gom9000/xp-presepe/backplane-board/README.md

# *Backplane* Board
BUS backplane with 7 slots for line boards.

board-built

## Schematic
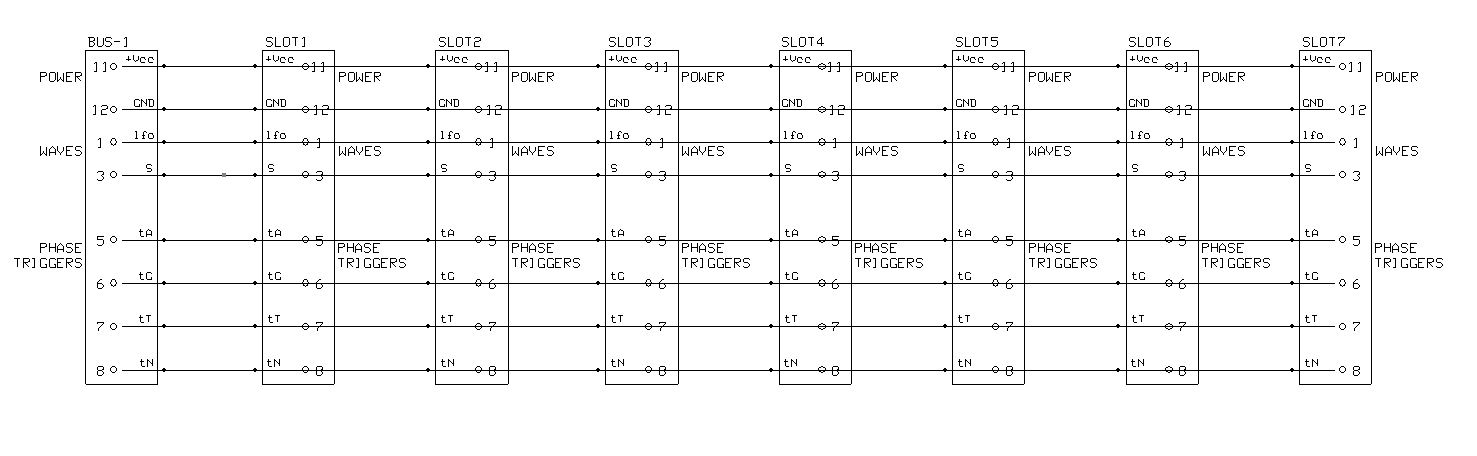
[picture p14: backplane-board/presepe-backplane-board_sch.jpg]
board-schematic


## PCB Layout
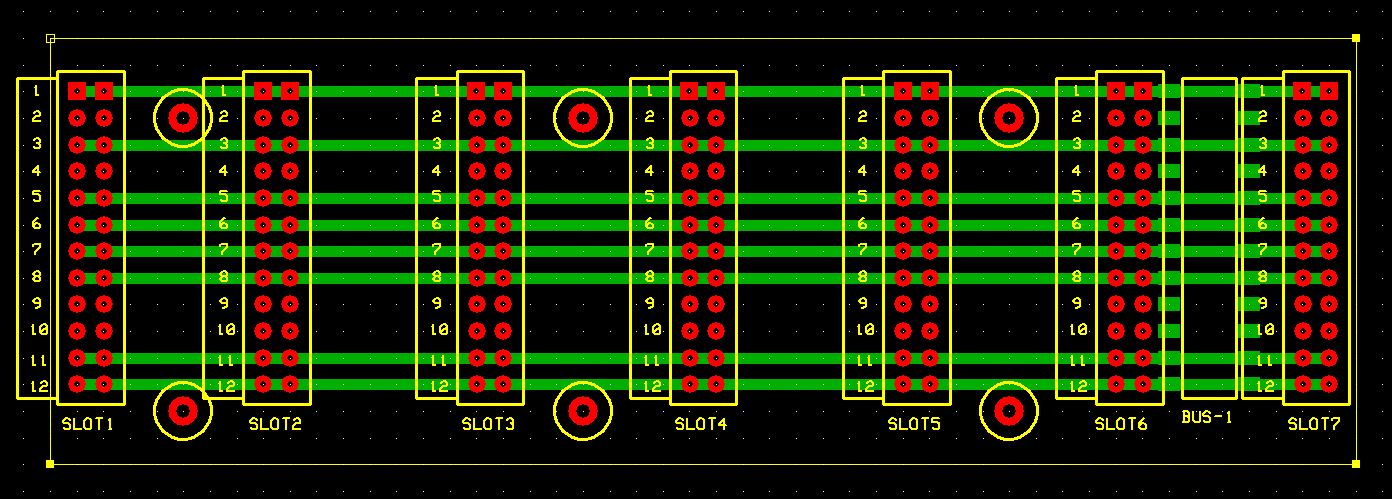
[picture p15: backplane-board/presepe-backplane-board_pcb.jpg]
board-pcb


## Bill of Materials
- [x] paperboard 15x9cm cropped to 47x15M (1M=.1inches)
- [x] 7 x DIL 12-pin female header
- [x] DIL 12-pin female header smd
