gom9000/xp-presepe/resources/ltspice-lfo.jpg

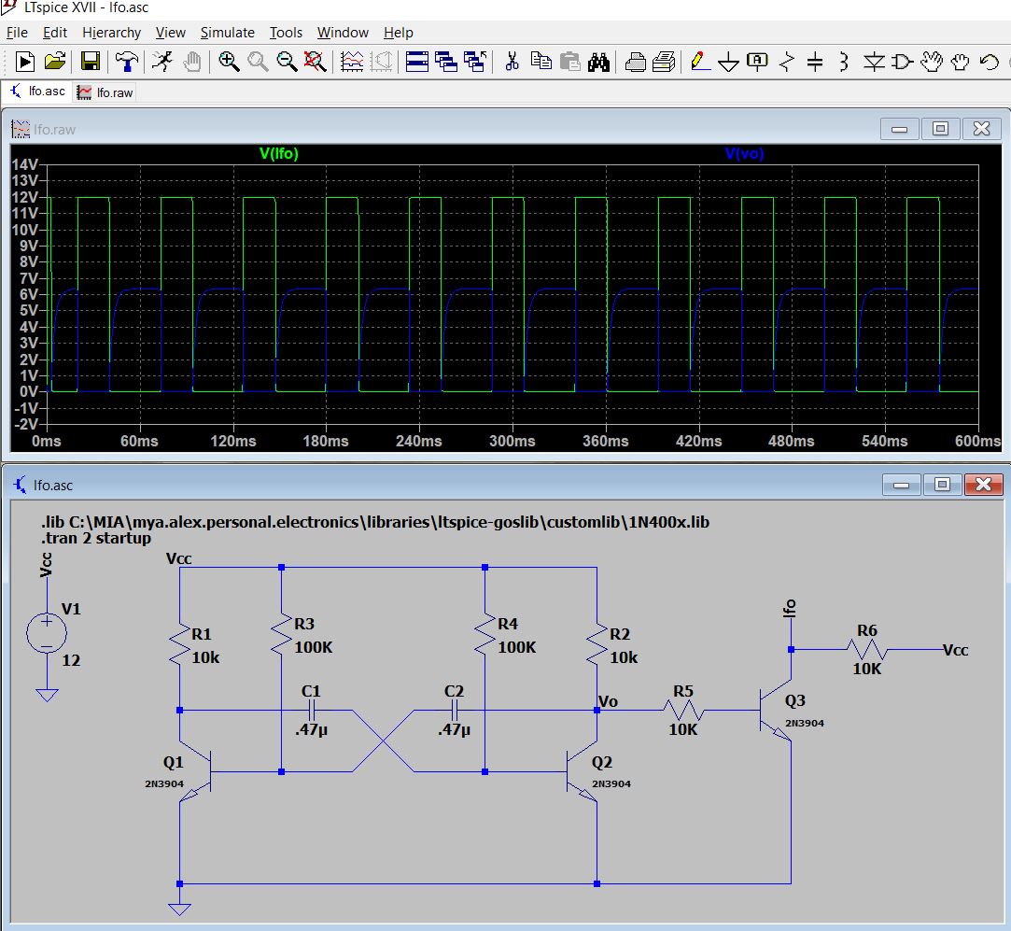
resources/ltspice-lfo.jpg
