gom9000/xp-presepe/resources/ltspice-phase-triggers-mixer.jpg

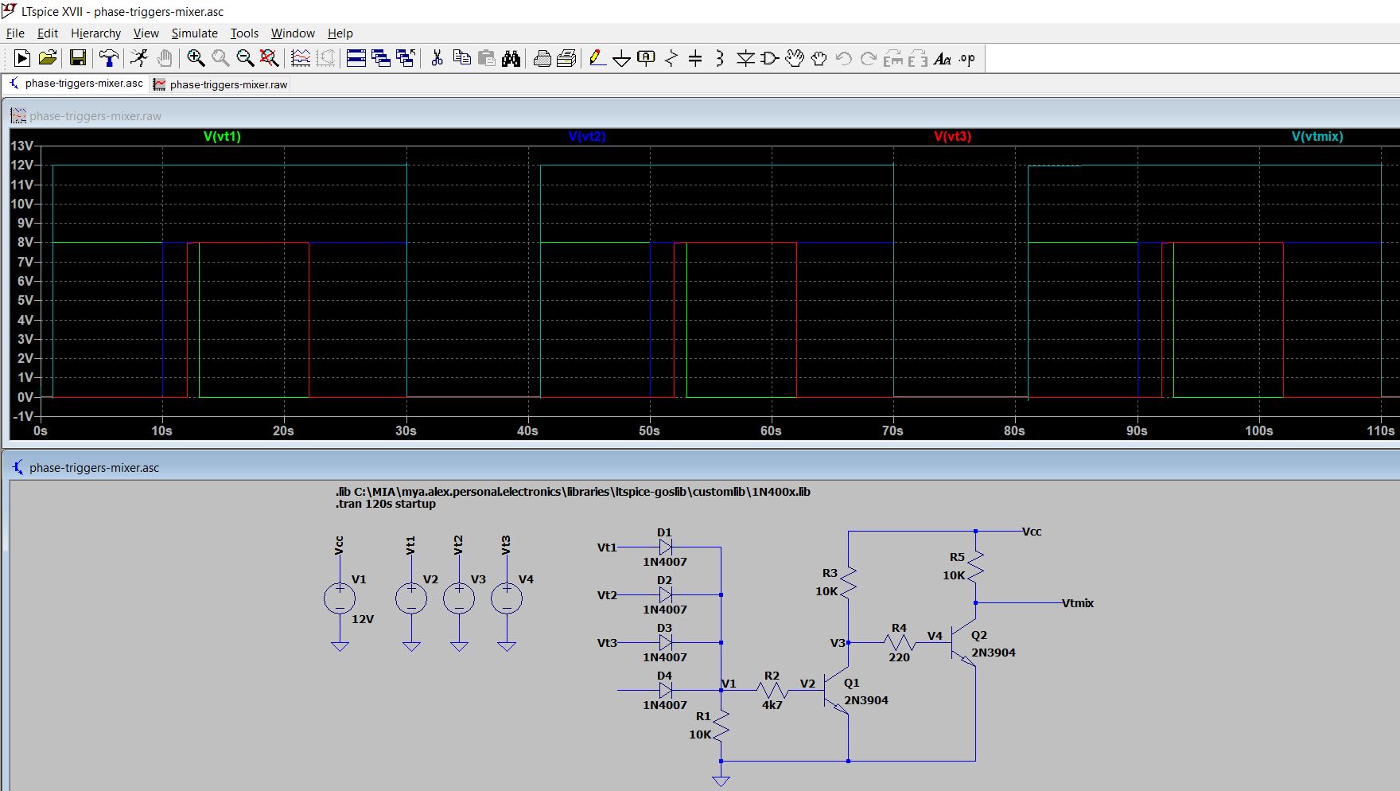
resources/ltspice-phase-triggers-mixer.jpg
