gom9000/xp-presepe/resources/ltspice-phase-triggers-voltage-reference.jpg

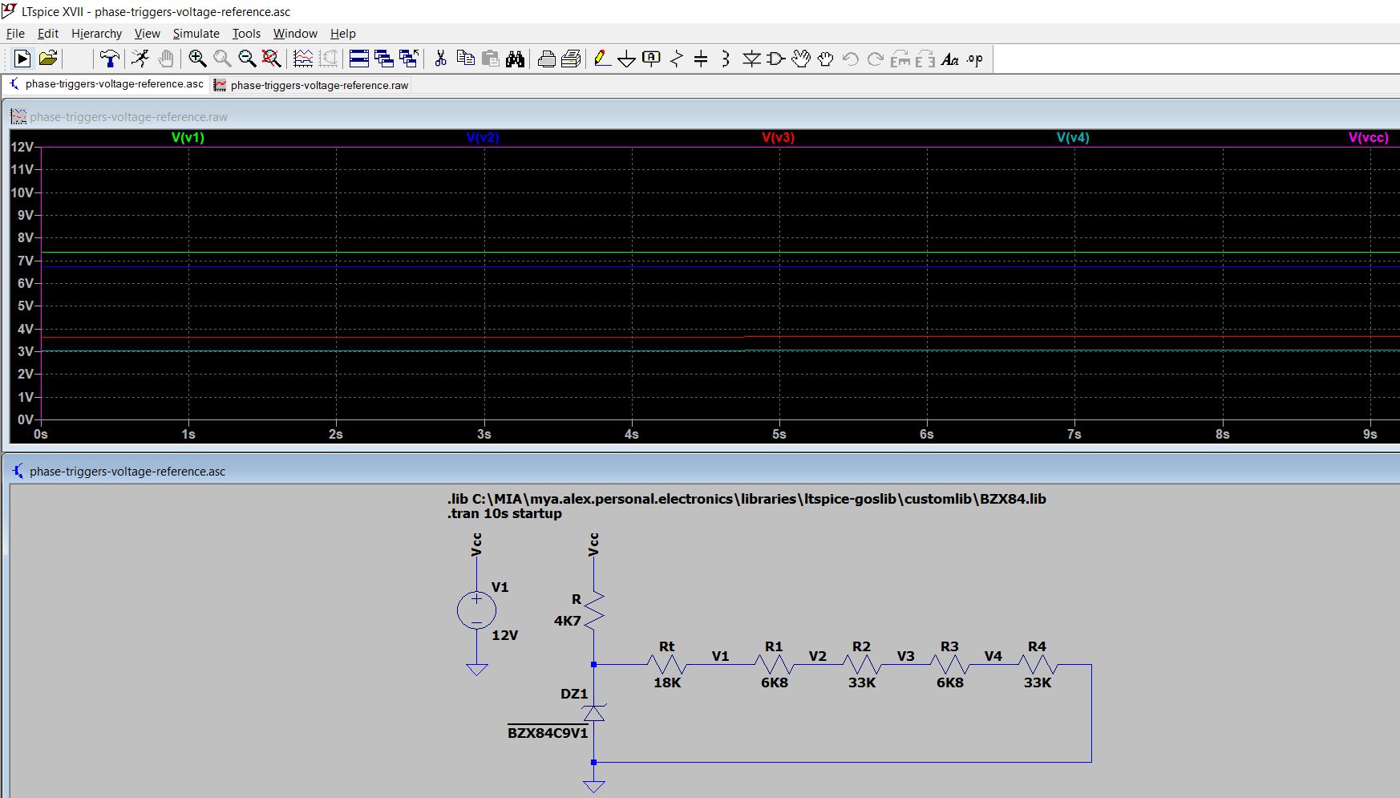
resources/ltspice-phase-triggers-voltage-reference.jpg
