gom9000/xp-presepe/resources/ltspice-sawtooth.jpg

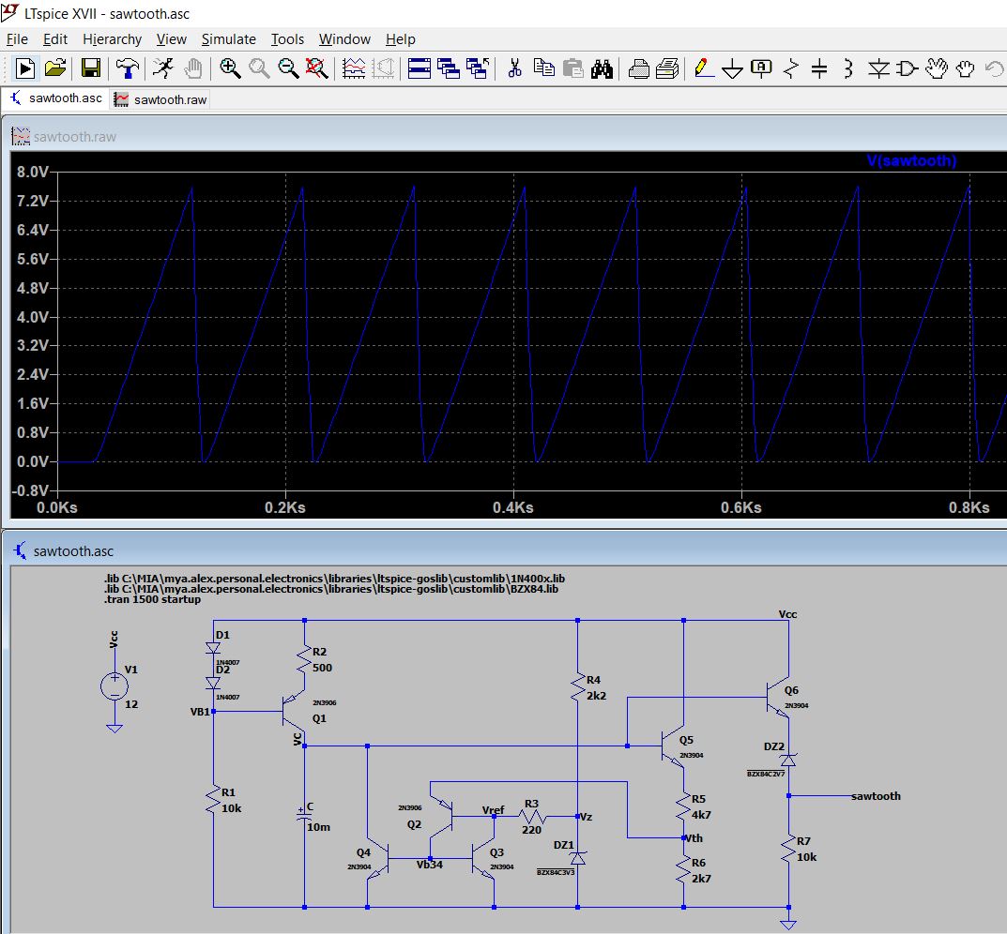
resources/ltspice-sawtooth.jpg
