gom9000/xp-presepe/resources/ltspice-transitions-generator.jpg

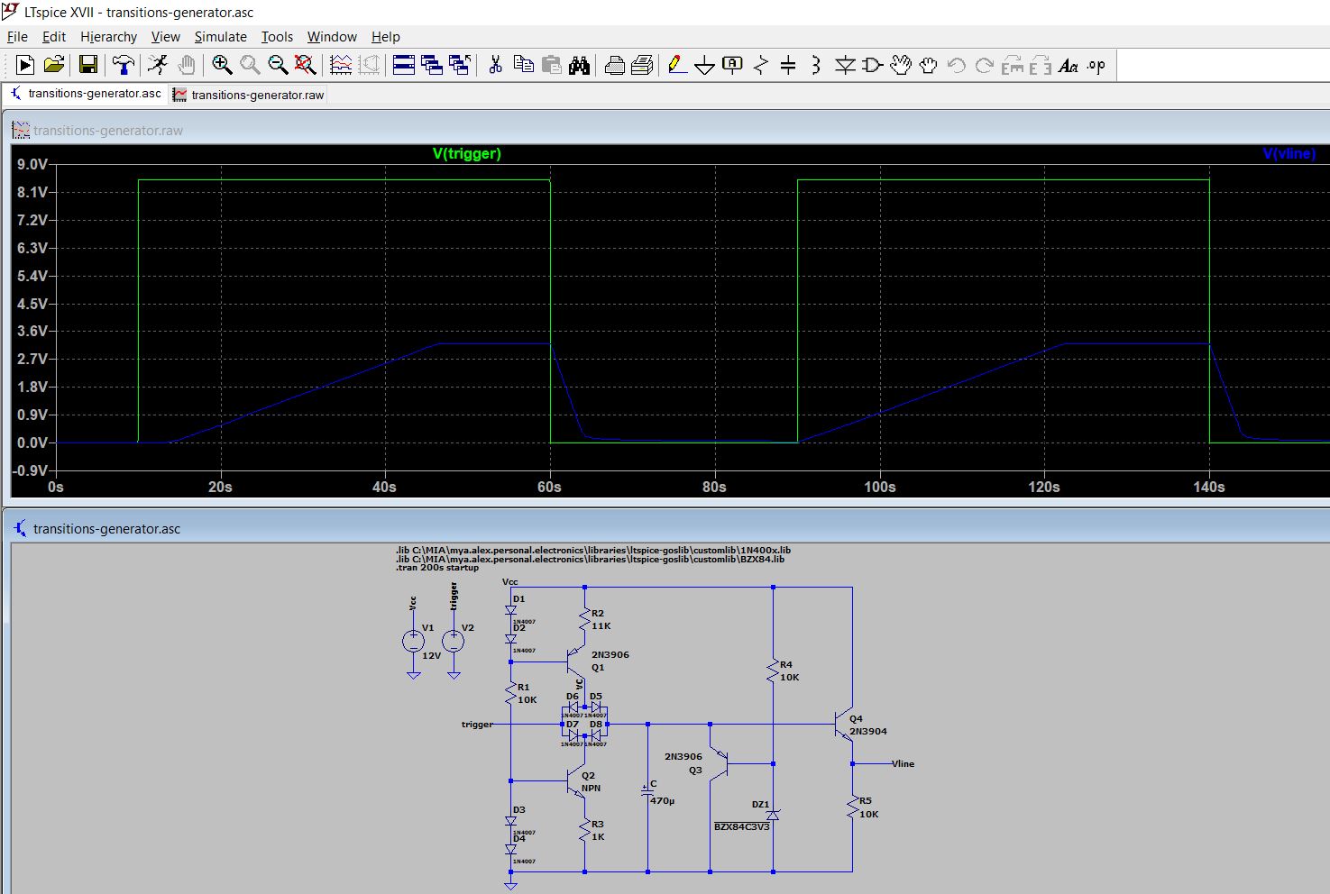
resources/ltspice-transitions-generator.jpg
