gom9000/xp-presepe/resources/ltspice-vline-lfo-mixer.jpg

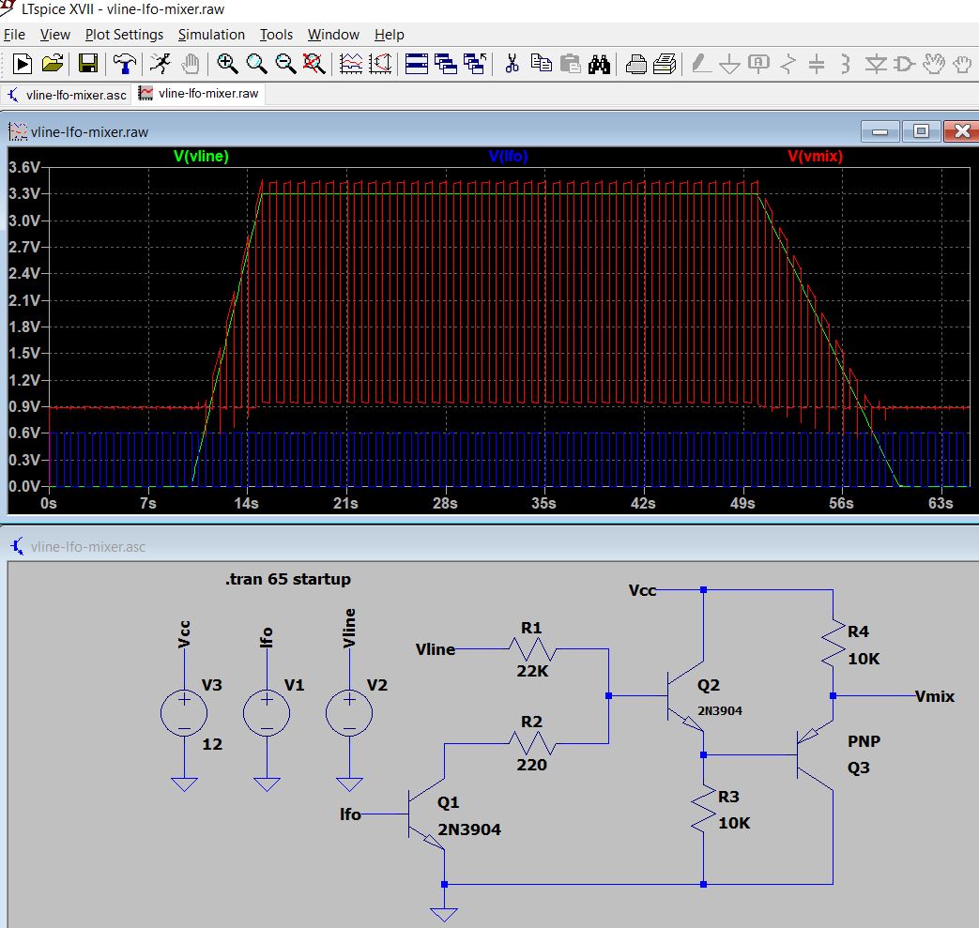
resources/ltspice-vline-lfo-mixer.jpg
