gom9000/xp-presepe/resources/ltspice-voltage-to-current-and-mirror.jpg

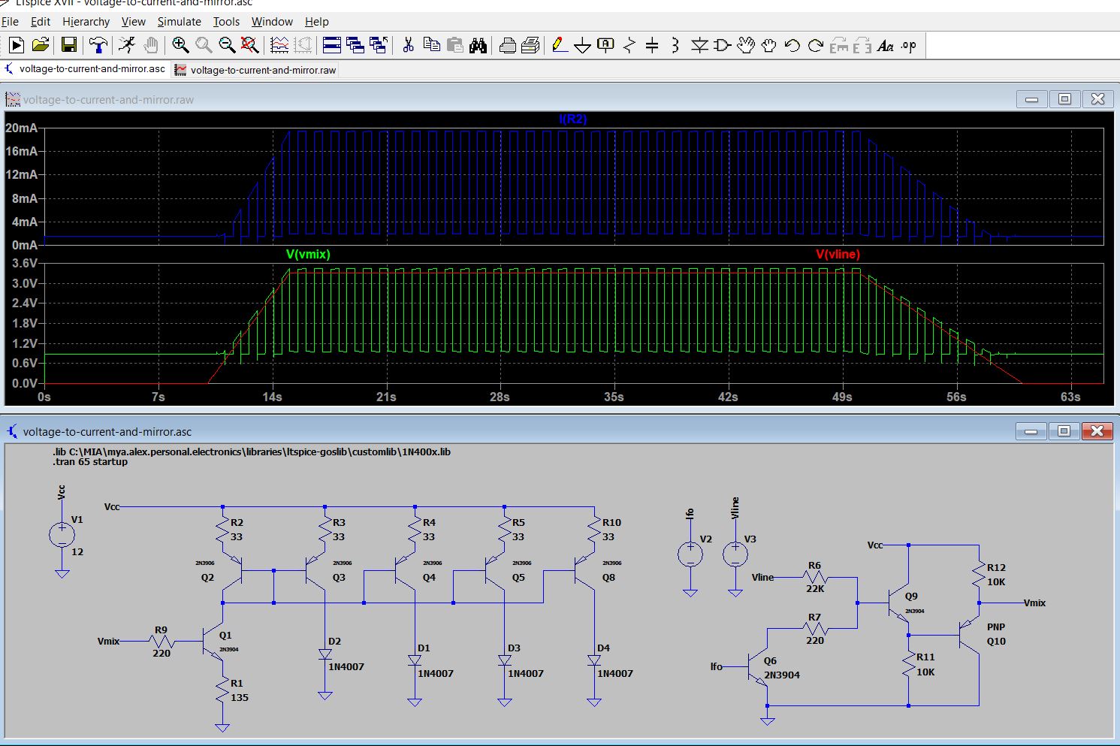
resources/ltspice-voltage-to-current-and-mirror.jpg
