gom9000/xp-presepe/resources/presepe-lfo.jpg

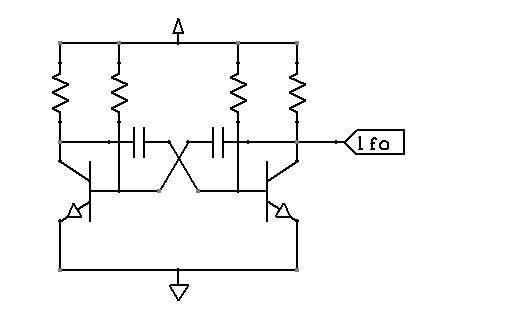
resources/presepe-lfo.jpg
