gom9000/xp-presepe/(list of files, drawings)

Other design files:
backplane-board/presepe-backplane-board.pcb
phases-lines-board/presepe-phases-lines-board.pcb
triggers-board/presepe-triggers-board.pcb
waves-board/presepe-waves-board.pcb
