gom9000/xp-presepe/(commit log)

2021-03-22 add phases lines board
    [presepe-phases-lines-board.pcb, presepe-phases-lines-board.sch]
2021-03-22 fix phases line board pcb
    [presepe-phases-lines-board.pcb]
2021-03-22 add logical modules images
    [presepe-modules.sch]
2021-03-23 fix phases-lines-board
    [presepe-phases-lines-board.pcb, presepe-phases-lines-board.sch]
2021-03-26 add backplane board
    [presepe-backplane-board.pcb, presepe-backplane-board.sch]
2021-03-27 add phases line board built
    [presepe-phases-lines-board.pcb]
2021-03-28 update backplane board
    [presepe-backplane-board.pcb]
2021-03-29 add main board schematics
    [presepe-main-board.pcb, presepe-main-board.sch]
2021-03-29 fix bom descriptions
2021-04-25 add triggers and waves board
    [presepe-backplane-board.pcb, presepe-backplane-board.sch, presepe-main-board.pcb, presepe-main-board.sch, presepe-triggers-board.pcb, presepe-triggers-board.sch, presepe-waves-board.sch]
2021-04-26 update waves board
    [presepe-waves-board.pcb]
2021-05-09 fit pcb to 9x15 paperboard
    [presepe-backplane-board.pcb, presepe-triggers-board.pcb, presepe-waves-board.pcb]
2022-05-19 update the sawtooth wave generator circuit
    [presepe-waves-board.sch]
2022-05-22 fix schematics and pcb, rename to xp-presepe-lights
    [presepe-backplane-board.sch, presepe-phases-lines-board.pcb, presepe-phases-lines-board.sch, presepe-triggers-board.pcb, presepe-triggers-board.sch, presepe-waves-board.sch]
2022-05-23 add ltspice simulations and updates
    [presepe-phases-lines-board.sch, presepe-waves-board.pcb, presepe-waves-board.sch]
